wojas/filmprocessor/doc/schematic/filmprocessor-schematic.png

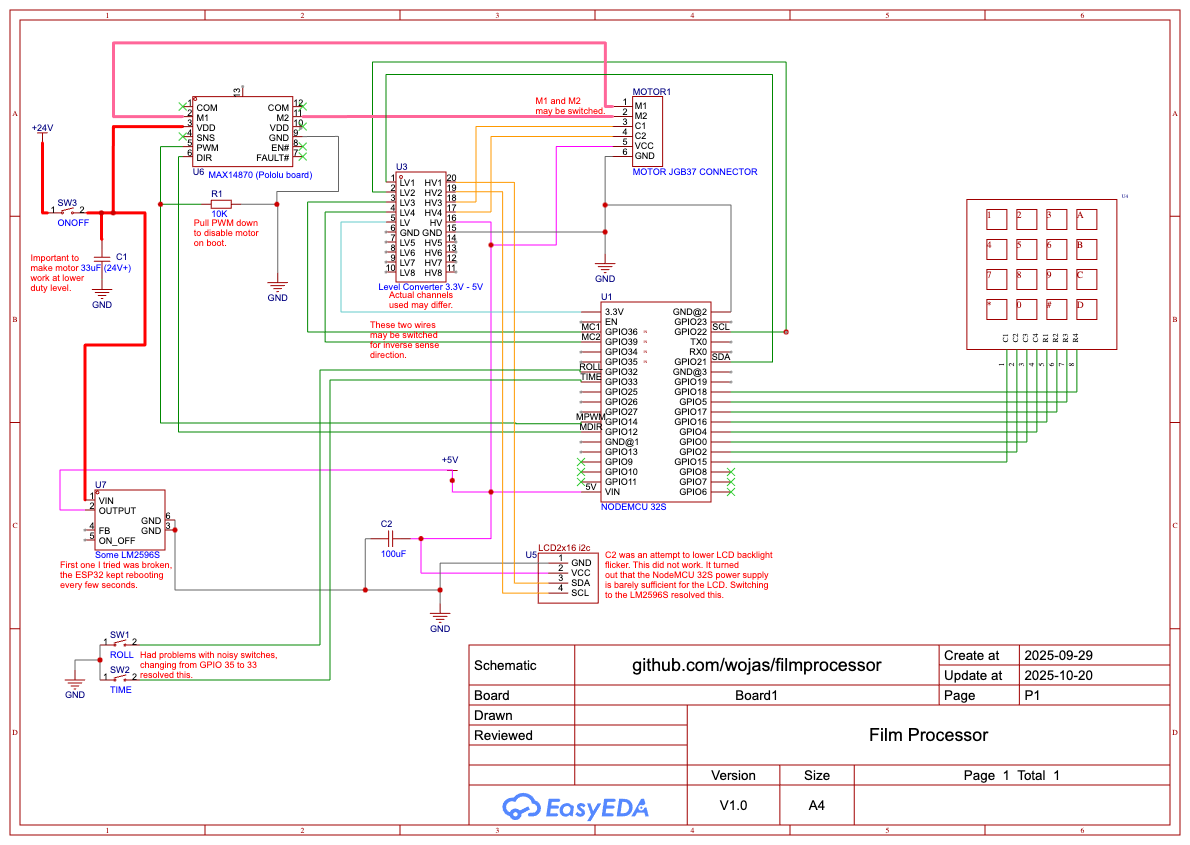
doc/schematic/filmprocessor-schematic.png
