wojas/filmprocessor/doc/schematic/filmprocessor-schematic.pdf

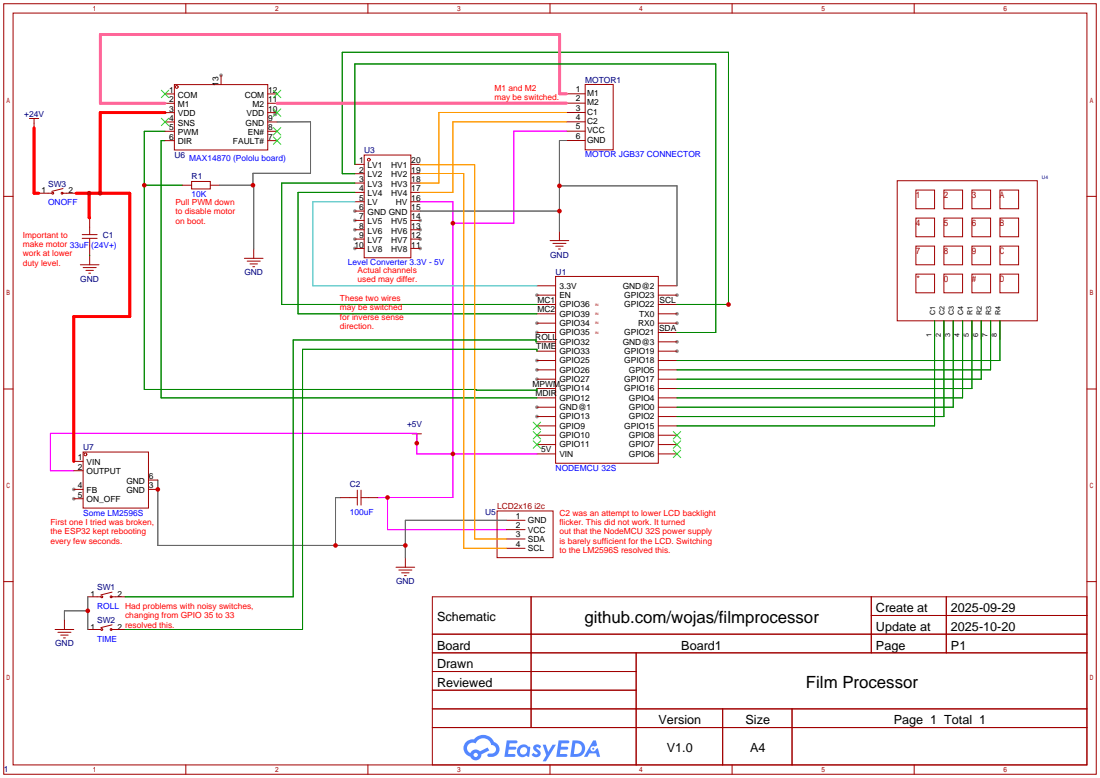
[picture p3: page 1]

may be switched
for inverse sense direction.

C2 was an attempt to lower LCD backlight
flicker. This did not work. It turned
out that the NodeMCU 32S power supply
is barely sufficient for the LCD. Switching
to the LM2596S resolved this.

Had problems with noisy switches,

Schematic | github.com/wojas/filmprocessor | Create at | 2025-09-29

Update at | 2025-10-20

Board | Board1 | Page | P1
Drawn | | Film Processor
Reviewed

Version | Size | Page 1 Total 1
V1.0 | A4
