wojas/filmprocessor/(list of files, drawings)

Other design files:
doc/schematic/filmprocessor.epro
