wojas/filmprocessor/include/secrets.example.h

#ifndef ESP32TEST_SECRETS_H
#define ESP32TEST_SECRETS_H

#define SECRET_WIFI_SSID ""
#define SECRET_WIFI_PASS ""

#define SECRET_MQTT_SERVER ""
#define SECRET_MQTT_USER ""
#define SECRET_MQTT_PASS ""

// NOTE: This MUST match "upload_flags = --auth=..." in your platformio.local.ini
#define SECRET_OTA_PASSWORD ""

#endif //ESP32TEST_SECRETS_H
