wojas/filmprocessor/(commit log)

2025-09-27 Neater motor control, but RPM wrong
    [main.cpp, motor.cpp, motor.h]
2025-09-27 Motor rpm correct
2025-09-28 comments and monitor filter
2025-09-28 motor controller with fixed duty cycle
    [main.cpp, motor.cpp, motor.h]
2025-09-28 mqtt motor control
2025-09-28 motor: reset DIR pin on boot
    [motor.cpp]
2025-09-28 keypad motor control
2025-09-30 motor: lower limit of 40
2025-09-30 lcd: better output and wifi
    - WiFi status on LCD
    - LCD error messages
    - LED blinking patterns on error
    - No reboot on wifi failure, just message
    - Position displayed with one custom character.
    [main.cpp]
2025-09-30 Buttons & motor pausing
2025-09-30 mqtt debug log buttons
2025-10-17 Fix noisy button
    The solution was a different gpio.
    [main.cpp]
2025-10-20 motor: adjusr gear ratio for 76 rpm version
2025-10-20 lcd: do not restart if the lcd is not available
    In case this happens in a session and we just want to finish developing
    our roll...
2025-10-20 doc: add schematic
    [filmprocessor.epro]
2025-10-22 motor: send detailed metrics over mqtt
2025-10-22 tools: script to plot motor metrics
2025-10-22 motor: flush buffered metrics on pause
2025-10-26 motor: use state machine
2025-10-26 motor: better control to avoid overshoots
    First 300ms do not exceed the estimate to avoid overshoot.
    [motor.cpp]
2025-10-26 motor: filtering for smoothness
    Smooth motor control by employing filtering for small deviations.
2025-10-31 screen: add Error screen
    [screen.cpp, screen.hpp]
2025-10-31 ota: use new Error screen
    [main.cpp]
2025-10-31 screen: add pagination state
    * track the number of consecutive renders per screen via page counter
    * persist screen/page for push/pop transitions so overlays restore context
2025-10-31 motor: support cycle progress bias
    * track target_progress and split cycle travel via rotation_delta_for_direction so forward/reverse strokes keep the net advance
    * surface progress control through MQTT, keypad parameter entry, and retuned presets (default 50° progress, updated RPM/duty/rotation targets)
    * publish progress in motor telemetry/logging and reuse the helper when reversing to keep deltas consistent
    [main.cpp, motor.cpp, motor.h]
2025-10-31 test: cover input matcher patterns
    Move InputMatch into lib/input_match so PlatformIO links it for both firmware and native test environments. Add Unity coverage for literal, numeric, reset, and star patterns, and introduce a native PlatformIO environment so the tests run without Arduino.
    [main.cpp]
2025-10-31 screen: enable native tests with local Arduino stub
    Use an in-repo Arduino shim for local testing of Screen with String.
2025-10-31 screen: clamp formatted minutes
    Limit the minute portion of Screen::formatTime to two digits so the %2lu formatter cannot overflow the 5-character LCD buffer.
2025-10-31 config: move motor defines to config.h
2025-10-31 fix: kp_handle string type issue
    [main.cpp]
2025-10-31 ci: run native and firmware builds
    Collapse CI into a single job that runs both the native unit test suite and the ESP32 firmware build so we catch type regressions early without extra setup overhead.
2025-10-31 wip: screen B for motor stats
2025-10-31 motor: add comments
2025-10-31 motor: add csv metrics
2025-10-31 motor: fix csv columns
    [motor.cpp]
2025-11-02 screen: git info build fixes
    [screen.cpp, version_info.hpp]
